davernicct/work_ide/git_shell_cmd_prototype_notes.txt

find . -maxdepth 3 -name .git -type d | rev | cut -c 6- | rev | xargs -I {} git -C {} pull // update every repo
