davernicct/work_ide/prototypes/pcb_prod_architecture/Architecture.docx

Nrfjprog : https://infocenter.nordicsemi.com/pdf/nRF5x_Command_Line_Tools_v1.0.pdf

SAM Driver

Programmer API (nrfprog)

Scenario manager

GUI (python)

nRF52 DK

Arduino

PCIe

Pcb proxy

Pcb frame panel

SAM

SWD Programmer

UUT N

….

UUT 2

UUT 1
