davernicct/work_ide/doc_git.docx

Sky_pcb_models

Tattoo_machine_models

…….

project_N

project_1

project_0

frame

components

mec_ide

…….

project_N

project_1

project_0

applications

firmware

modules

integration

external

components

sft_ide

…….

project_N

project_1

project_0

pcb

components

ele_ide

work_ide
