davernicct/work_ide/prototypes/pcb_prod_architecture/register_map.xlsx

par convention : les registres sont sur 32 bits little endian
 | On test une carte à la fois
adr | data | dir | commentaire | designation
1 | pb_rst_n | RW |  | bouton poussoir reset radio
2 | pb_n+ | RW | test non automatisable pour le moment | bouton poussoir incrément sensibilité
3 | pb_n- | RW | test non automatisable pour le moment | bouton poussoir decrément sensibilité
4 | led_blc_n | RO |  | Afficheur LED status batterie
5 | T_led_blc_n | RO |  | Periode du signal led_blc
6 | led_sync | RO |  | Afficheur LED status connexion radio
7 | T_led_sync | RO |  | Periode du signal led_sync
8 | Alim | RO | mesure sur 8bits (range ADC) | valeur de tension de l'alimentation
9 | nrfcmd | RO |  | control de l'alimentation dermographe
10 | chipselect | RW |  | selection de l'UUT courante
