davernicct/work_ide/prototypes/pcb_prod_architecture/HMI.docx

Set1

Set0

In0

I1

Out0

Out1

Out2

UUT1

Set1

Set0

UUT2

In0

I1

Out0

Out1

Out2

….

Selectionner un scénario

Selectionner une carte cible

Actualiser les scénarios

….

Selection

LANCEMENT

UUTN

SAM X.X Rev X
