davernicct/work_ide/prototypes/pcb_prod_architecture/HMI_RevA.pdf

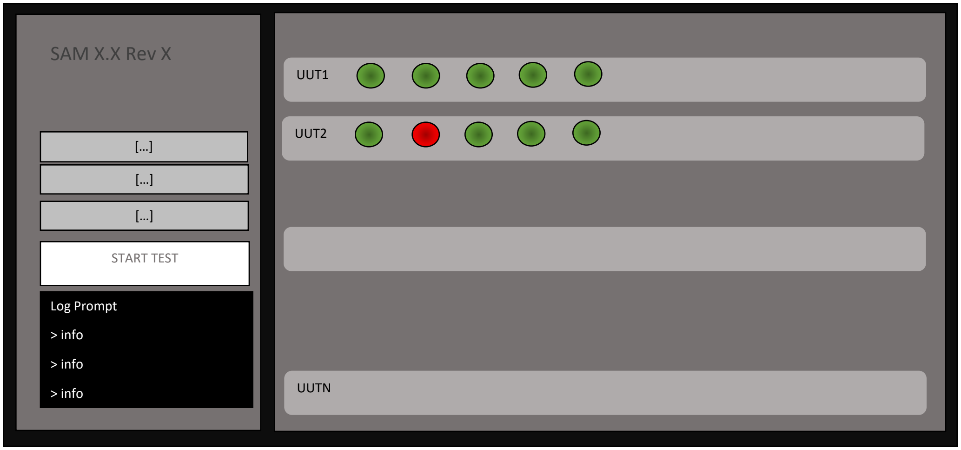
[picture p1: figure]
START TEST; Log Prompt; > info; SAM X.X Rev X; UUT1; UUTN; UUT2
