davernicct/work_ide/prototypes/pcb_prod_architecture/bottom.png

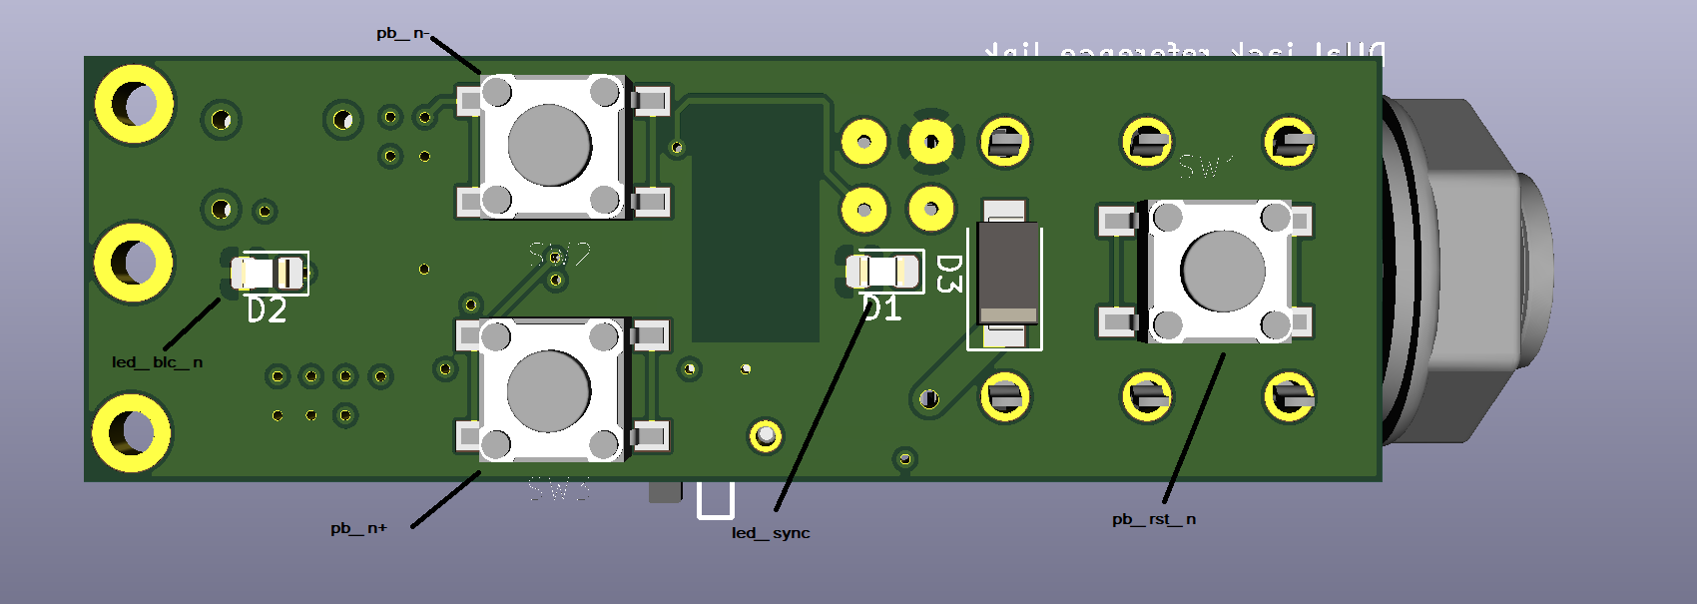
prototypes/pcb_prod_architecture/bottom.png
