davernicct/work_ide/prototypes/pcb_prod_architecture/top.png

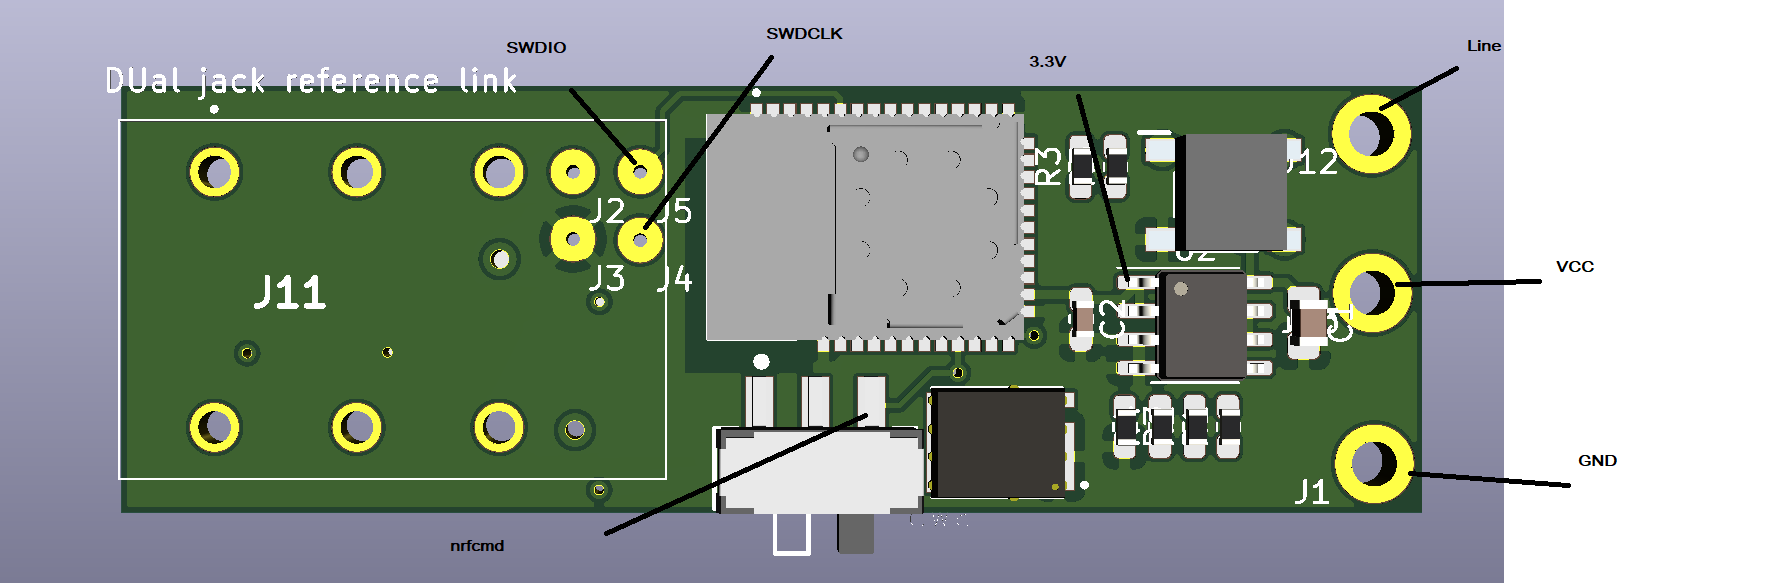
prototypes/pcb_prod_architecture/top.png
