davernicct/work_ide/prototypes/pcb_prod_architecture/Untitled.png

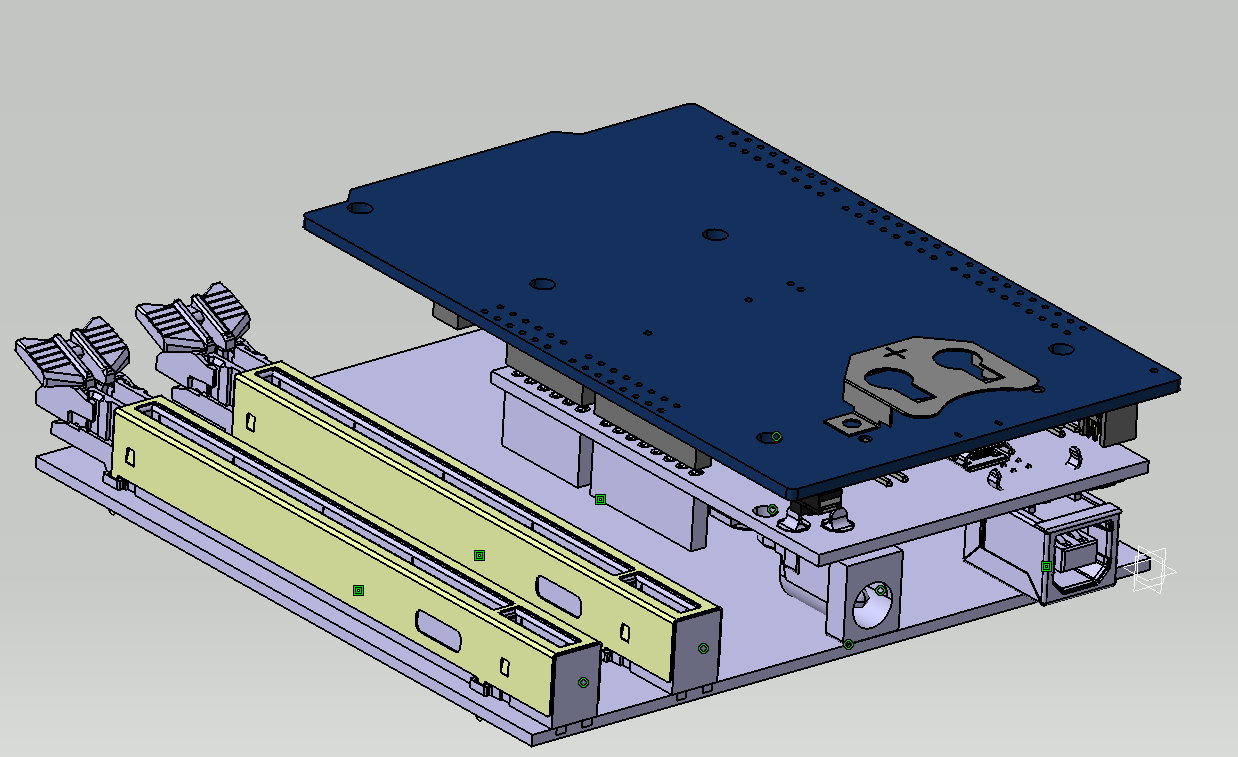
prototypes/pcb_prod_architecture/Untitled.png
