davernicct/work_ide/visual.png

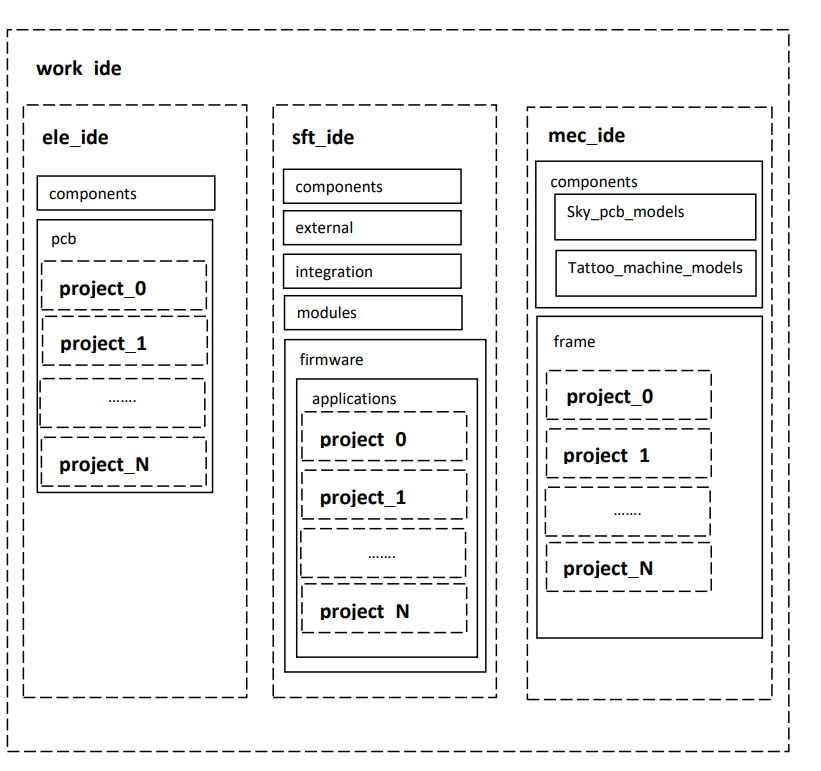
visual.png
