davernicct/work_ide/BOMs/BOM_globale.xlsx

Sheet: Guide de commande
Quantité à produire | 2 | BOM Commande |  |  |  |  |  |  | BOS Commande
Total BOM | 201.49 | Designation | Quantité | Coût/unité article | Quantité pièces/article | Quantité pièces production | Quantité article à commander | Coût cummulé | Service | fournisseur | Capacité et coût
 |  | 10104110-0001LF | 1 | 0.669 | 10 | 2 | 1 | 6.69 | PAR | PCB-WAY | UO | 5 | 20 | 50
 |  | ABS10A13 | 1 | 0.271 | 1 | 2 | 2 | 0.542 |  |  | Prix/UO
 |  | ACJSMHDR | 1 | 1.05 | 1 | 2 | 2 | 2.1
 |  | B3S-1000 | 3 | 0.582 | 1 | 6 | 6 | 3.492
 |  | BL651 farnell | 1 | 6 | 1 | 2 | 2 | 12
 |  | BL652 mouser | 1 | 7 | 1 | 2 | 2 | 14
 |  | BSC016N06NS | 1 | 2.16 | 1 | 2 | 2 | 4.32
 |  | Câble multibrins 0.032mm² | 1 | 0.0007 | 500 | 2 | 1 | 0.35
 |  | Cap 4.7uC 0603 | 2 | 0.135 | 10 | 4 | 1 | 1.35
 |  | Cap 47uC 0603 | 2 | 0.44 | 5 | 4 | 1 | 2.2
 |  | Câble chargeur batterie | 1 | 5.95 | 2 | 2 | 1 | 11.9
 |  | Connecteur fil à carte | 1 | 0.217 | 1 | 2 | 2 | 0.434
 |  | DMC2400UV | 1 | 0.182 | 5 | 2 | 1 | 0.91
 |  | FSR | 1 | 5.05 | 1 | 2 | 2 | 10.1
 |  | Câble multiconducteurs | 1 | 0.152 | 6 | 2 | 1 | 0.912
 |  | Gaine Thr | 1 | 0.176 | 143 | 2 | 1 | 25.168
 |  | Contact PicoBlade | 3 | 0.0263 | 10 | 6 | 1 | 0.263
 |  | JS102011SAQN | 1 | 0.442 | 1 | 2 | 2 | 0.884
 |  | kit boitiers I.Materialise | 1 | 24.99 | 1 | 2 | 2 | 49.98
 |  | LED lens | 2 | 0.115 | 5 | 4 | 1 | 0.575
 |  | Li-Ion | 1 | 15.14 | 1 | 2 | 2 | 30.28
 |  | LP2951-3.3_SOIC | 1 | 0.621 | 1 | 2 | 2 | 1.242
 |  | MCP4461-103E/ML | 1 | 1.69 | 1 | 2 | 2 | 3.38
 |  | MCP73831T-2ACI/OT | 1 | 0.519 | 1 | 2 | 2 | 1.038
 |  | LED_RG | 1 | 0.256 | 5 | 2 | 1 | 1.28
 |  | LED_White | 1 | 0.957 | 1 | 2 | 2 | 1.914
 |  | MCP6541T-I_OT | 1 | 0.334 | 1 | 2 | 2 | 0.668
 |  | PS000122 | 1 | 1.66 | 1 | 2 | 2 | 3.32
 |  | MMSD4148T1G | 2 | 0.125 | 1 | 4 | 4 | 0.5
 |  | Res 10Kr 0603 | 12 | 0.0044 | 10 | 24 | 3 | 0.132
 |  | Res 1.5Mr 0603 | 1 | 0.0265 | 10 | 2 | 1 | 0.265
 |  | pcb JLCPCB | 1 | 1.8 | 5 | 2 | 1 | 9
 |  | Res 180Kr 0603 | 1 | 0.0252 | 10 | 2 | 1 | 0.252
 |  | Res 220r 0603 | 3 | 0.0049 | 10 | 6 | 1 | 0.049

Sheet: BOM Unité
BOM Unité
Designation | Quantité | Coût/unité article | Quantité pièces/article | Coût cummulé | Fournisseur | Lien fournisseur | Catégorie | PCBA | BOM/unité | 78.7798
10104110-0001LF | 1 | 0.669 | 10 | 0.669 | Farnell | https://fr.farnell.com/amphenol-icc-fci/10104110-0001lf/embase-micro-usb-2-0-type-b-cms/dp/2293753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|pcrid|80994017342|plid||kword||match||slid||product|2293753|pgrid|18029979182|ptaid|aud-890751158535:pla-41477300408|&CMP=KNC-GFR-GEN-SHOPPING_TEST_93_08-APR-2020_T | CMP-G-COMMON | Y-SMD | CMP | 45.8638 | R-COMMON | 15.2709
ABS10A13 | 1 | 0.271 | 1 | 0.271 | Farnell | https://fr.farnell.com/diodes-inc/abs10a-13/diode-pont-redresseur-1-ph-1a/dp/3127182?st=ABS10A13 | CMP-R-COMMON | Y-SMD |  |  | G-COMMON | 29.8885
ACJSMHDR | 1 | 1.05 | 1 | 1.05 | Farnell | https://fr.farnell.com/amphenol/acjs-mhdr/jack-6-35mm-pcb-stereo/dp/1835537?st=ACJSMHDR | CMP-R-COMMON | N |  |  | COMMON | 0.7044
B3S-1000 | 3 | 0.582 | 1 | 1.746 | Farnell | https://fr.farnell.com/omron/b3s-1000/commutateur-cms-spno-50ma/dp/177807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 | CMP-R-COMMON | Y-SMD | PCB | 1.8 | R-COMMON | 0
BL651 farnell | 1 | 6 | 1 | 6 | farnell | https://fr.farnell.com/laird/453-00005c/bl651-series-bt-v5-module-int/dp/3020333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 (https://fr.farnell.com/laird-technologies/bl652-sa-01/module-ble-nfc-2-402-2-48ghz-96dbm/dp/2664536?st=BL652) | CMP-G-COMMON | Y-SMD |  |  | G-COMMON | 0
BL652 mouser | 1 | 7 | 1 | 7 | mouser | https://www.mouser.fr/ProductDetail/Laird-Connectivity/BL652-SA-01 (https://fr.farnell.com/laird/453-00005c/bl651-series-bt-v5-module-int/dp/3020333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) | CMP-R-COMMON | Y-SMD |  |  | COMMON | 1.8
BSC016N06NS | 1 | 2.16 | 1 | 2.16 | Farnell | https://fr.farnell.com/infineon/bsc016n06nsatma1/mosfet-canal-n-60v-100a-tdson/dp/2432702?st=BSC016N06NSATMA1 | CMP-R-COMMON | Y-SMD | BTR | 31.116 | R-COMMON | 0
Câble multibrins 0.032mm² | 1 | 0.0007 | 500 | 0.0007 | Farnell | https://fr.farnell.com/concordia-technologies/6009404/cable-equipment-wire-7-0-20mm/dp/3377814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 | CMP-G-COMMON | / |  |  | G-COMMON | 6.126
Câble multiconducteurs | 1 | 0.152 | 6 | 0.152 | Farnell | https://fr.farnell.com/pro-power/2183y-0-50mmblk/cable-flex-2183y-0-50mm-noir-au/dp/1387675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 | CMP-R-COMMON | / |  |  | COMMON | 24.99
Cap 4.7uC 0603 | 2 | 0.135 | 10 | 0.27 | Farnell | https://fr.farnell.com/yageo/cc0603zry5v5bb475/condensateur-4-7-f-6-3v-y5v-0603/dp/9402128 | CMP-COMMON | Y-SMD
Cap 47uC 0603 | 2 | 0.44 | 5 | 0.88 | Farnell | https://fr.farnell.com/murata/grm21br60j476me15l/condensateur-47-f-6-3v-20-x5r/dp/2362109 | CMP-COMMON | Y-SMD
Câble chargeur batterie | 1 | 5.95 | 2 | 5.95 | NetDot | https://www.amazon.fr/gp/product/B07CHCV7M6/ref=ppx_yo_dt_b_asin_title_o01_s00?ie=UTF8&psc=1 | BTR-G-COMMON | /
Connecteur fil à carte | 1 | 0.217 | 1 | 0.217 | Farnell | https://fr.farnell.com/molex/51047-0300/connecteur-male-3-voies-1-rangee/dp/2112415?st=510470300 | CMP-G-COMMON | / | BOS
Contact PicoBlade | 3 | 0.0263 | 10 | 0.0789 | Farnell | https://fr.farnell.com/molex/50125-8000/contact-m-le-26awg-a-sertir/dp/1756745?st=501258000 | CMP-G-COMMON | / | SMD | 21 | 39
DMC2400UV | 1 | 0.182 | 5 | 0.182 | Farnell | https://fr.farnell.com/diodes-inc/dmc2400uv-7/mosfet-canal-n-p-20v-sot-563-6/dp/2543523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 | CMP-G-COMMON | Y-SMD | THUH | 1 | 1
FSR | 1 | 5.05 | 1 | 5.05 | Farnell | https://fr.farnell.com/multicomp/mcwr06x1002ftl/res-couche-epaisse-10k-1-0-1w/dp/2447230 | CMP-G-COMMON | /
Gaine Thr | 1 | 0.176 | 143 | 0.176 | Farnell | https://fr.farnell.com/pro-power/13654/gaine-thermo-2-1-noir-50-8-5m/dp/1008451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 | BTR-G-COMMON | /
JS102011SAQN | 1 | 0.442 | 1 | 0.442 | Farnell | https://fr.farnell.com/c-k-components/js102011saqn/commutateur-spdt-0-6a-6vdc-lateral/dp/2320017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 | CMP-R-COMMON | Y-SMD
kit boitiers I.Materialise | 1 | 24.99 | 1 | 24.99 | I.Materialise |  | BTR-COMMON | /
LED lens | 2 | 0.115 | 5 | 0.23 | Farnell | https://fr.farnell.com/vcc-visual-communications-company/cmc321ctp/lentille-led-5mm-pc-transparent/dp/2750614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 | CMP-R-COMMON | /
LED_RG | 1 | 0.256 | 5 | 0.256 | Farnell | https://fr.farnell.com/kingbright/kptb-1612surkcgkc/led-cms-80-50mcd-rouge-vert/dp/2426234?st=KPTB1612SURKCGKC | CMP-R-COMMON | Y-SMD
LED_White | 1 | 0.957 | 1 | 0.957 | Farnell | https://fr.farnell.com/broadcom-limited/hsmw-c191/led-cms-blanc/dp/1058375 | CMP-R-COMMON | Y-SMD
Li-Ion | 1 | 15.14 | 1 | 15.14 | Farnell | https://fr.farnell.com/bak/lp-402025-is-3/batterie-lithium-pol-3-7v-165/dp/2077885 | CMP-G-COMMON | /
LP2951-3.3_SOIC | 1 | 0.621 | 1 | 0.621 | Farnell | https://fr.farnell.com/texas-instruments/lp2951-33d/ic-volt-reg-3-3v-mcrpwr-sd-8soic/dp/3122132?st=LP2951-33D | CMP-R-COMMON | Y-ThuHole
MCP4461-103E/ML | 1 | 1.69 | 1 | 1.69 | Farnell | https://fr.farnell.com/microchip/mcp4461-103e-ml/ic-dgtl-pot-257taps-10k-20qfn/dp/1863948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 | CMP-G-COMMON | Y-SMD
MCP6541T-I_OT | 1 | 0.334 | 1 | 0.334 | Farnell | https://fr.farnell.com/microchip/mcp6541t-i-ot/comp-pushpull-1-6v-sngl-5sot23/dp/1825063?st=MCP6541T-I_OT | CMP-G-COMMON | Y-SMD
MCP73831T-2ACI/OT | 1 | 0.519 | 1 | 0.519 | Farnell | https://fr.farnell.com/microchip/mcp73831t-2aci-ot/controleur-de-charge-li-ion-li/dp/1332158?st=MCP73831 | CMP-G-COMMON | Y-SMD
MMSD4148T1G | 2 | 0.125 | 1 | 0.25 | Farnell | https://fr.farnell.com/on-semiconductor/mmsd4148t1g/diode-rapide-sod-123/dp/9556079?st=MMSD4148T1G | CMP-COMMON | Y-SMD
pcb JLCPCB | 1 | 1.8 | 5 | 1.8 | JLCPCB | / | PCB-COMMON | /
PS000122 | 1 | 1.66 | 1 | 1.66 | Farnell | https://fr.farnell.com/pro-signal/ps000122/phone-audio-conn-plug-3pos-6-35mm/dp/2910967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 | CMP-R-COMMON | /
Res 1.5Mr 0603 | 1 | 0.0265 | 10 | 0.0265 | Farnell | https://fr.farnell.com/yageo/rc0603fr-071m5l/res-couche-epaisse-1m5-1-0-1w/dp/9238867 | CMP-G-COMMON | Y-SMD
Res 10Kr 0603 | 12 | 0.0044 | 10 | 0.0528 | Farnell | https://fr.farnell.com/multicomp/mcwr06x1002ftl/res-couche-epaisse-10k-1-0-1w/dp/2447230 | CMP-COMMON | Y-SMD
Res 180Kr 0603 | 1 | 0.0252 | 10 | 0.0252 | Farnell | https://fr.farnell.com/yageo/rc0603fr-07180kl/res-couche-epaisse-180k-1-0-1w/dp/9238751 | CMP-G-COMMON | Y-SMD
Res 1Mr 0603 | 1 | 0.0088 | 10 | 0.0088 | Farnell | https://fr.farnell.com/multicomp/mcmr06x1004ftl/res-ceramique-1m-1-0-1w-0603/dp/2073351 | CMP-G-COMMON | Y-SMD
Res 220r 0603 | 3 | 0.0049 | 10 | 0.0147 | Farnell | https://fr.farnell.com/multicomp/mcwr06x2200ftl/res-couche-epaisse-220r-1-0-1w/dp/2447298 | CMP-R-COMMON | Y-SMD

Sheet: BOM Multiref
Liste fournisseurs | PCBA status | Multiref boitiers |  |  |  |  | Multiref pcb
Farnell | / | reference article | Coût/unité article | Quantité pièces/article | Fournisseur | Lien fournisseur | reference article | Coût/unité article | Quantité pièces/article | Fournisseur | Lien fournisseur
Sculpteo | N | kit boitiers Sculpteo | 51.07 | 1 | Sculpteo | / | pcb JLCPCB | 1.8 | 5 | JLCPCB | /
JLCPCB | Y-SMD | kit boitiers I.Materialise | 24.99 | 1 | I.Materialise | /
Mouser | Y-ThuHole | / | 30 | 1 | type2
 |  | / | 30 | 1 | type3 | /
 |  | Multiref BL651
 |  | reference article | Coût/unité article | Quantité pièces/article | Fournisseur | Lien fournisseur
 |  | BL651 farnell | 6 | 1 | farnell | https://fr.farnell.com/laird/453-00005c/bl651-series-bt-v5-module-int/dp/3020333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
 |  | BL651 mouser | 4.76 | 1 | mouser | https://www.mouser.fr/ProductDetail/Laird-Connectivity/453-00006
 |  | Multiref BL652
 |  | reference article | Coût/unité article | Quantité pièces/article | Fournisseur | Lien fournisseur
 |  | BL652 farnell | 8.39 | 1 | farnell | https://fr.farnell.com/laird-technologies/bl652-sa-01/module-ble-nfc-2-402-2-48ghz-96dbm/dp/2664536?st=BL652
 |  | BL652 mouser | 7 | 1 | mouser | https://www.mouser.fr/ProductDetail/Laird-Connectivity/BL652-SA-01
