davernicct/work_ide/BOMs/ele_BOM_SKY_misc.xlsx

Quantity | Designation | Commentaire | Fournisseur | lien | Pu
1 | Commutateur alim demo | Demo only | farnell | https://fr.farnell.com/nidec-copal/mfs201n-z/commut-glissiere-dpdt-1a-120v/dp/2854848 | 1.03
2 | CR2032 | Demo only | farnell | https://fr.farnell.com/renata/cr-2032-mfr-rv/pile-bouton-3-broches-3v/dp/1823483?st=CR2032 | 1.02
1 | NYS224 | External supply only, cette référence peut -être moins chère | farnell | https://fr.farnell.com/rean/nys224bg/fiche-male-6-35mm-2-voies-noire/dp/1813728?st=NYS224 | 3.38
 |  |  |  | Total | 5.43
