davernicct/work_ide/BOMs/ele_BOM_SKY_R.xlsx

 |  |  |  |  |  | Mouser |  |  | Farnell
Id | Designator | Package | Quantity | Designation | Commentaire | lien | Pu | Total | lien | Pu | Total
1 | Q1 | BSC016N06NS | 1 | Q_NMOS_GSD | / | https://www.mouser.fr/ProductDetail/Infineon-Technologies/BSC016N06NS | 1.85 | 1.85 | https://fr.farnell.com/infineon/bsc016n06nsatma1/mosfet-canal-n-60v-100a-tdson/dp/2432702?st=BSC016N06NSATMA1 | 2.16 | 2.16
2 | J11 | ACJSMHDR | 1 | AudioJack3_Dual_Switch | / | https://www.mouser.fr/ProductDetail/Amphenol-Audio/ACJS-MHDR | 1.28 | 1.28 | https://fr.farnell.com/amphenol/acjs-mhdr/jack-6-35mm-pcb-stereo/dp/1835537?st=ACJSMHDR | 1.05 | 1.05
3 | J5,J4,J3,J2 | ProbePad | 4 | Conn_01x01 | NC | / | 0 | 0 | / | 0 | 0
4 | J13,J12,J1 | PowerPad | 3 | Conn_01x01 | NC | / | 0 | 0 | / | 0 | 0
5 | IC1 | 45300005 | 1 | 453-00005 | stock volatile | https://www.mouser.fr/ProductDetail/Laird-Connectivity/BL652-SA-01-T-R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 | 6.71 | 6.71 | https://fr.farnell.com/laird-technologies/bl652-sa-01/module-ble-nfc-2-402-2-48ghz-96dbm/dp/2664536?st=BL652 | 8.23 | 8.23
6 | R7,R3,R2,R1 | R_0603_1608Metric_Pad1.05x0.95mm_HandSolder | 4 | 10kR | prix générique | / | 0.45 | 1.8 | / | 0.45 | 1.8
7 | R5,R4 | R_0603_1608Metric_Pad1.05x0.95mm_HandSolder | 2 | 220R | prix générique | / | 0.45 | 0.9 | / | 0.45 | 0.9
8 | C1 | C_0805_2012Metric_Pad1.15x1.40mm_HandSolder | 1 | 4.7uC | prix générique | / | 0.45 | 0.45 | / | 0.45 | 0.45
9 | SW2,SW3,SW1 | SW_B3S-1000 | 3 | B3S-1000 | / | https://www.mouser.fr/ProductDetail/Omron-Electronics/B3S-1000 | 0.531 | 1.593 | https://fr.farnell.com/omron/b3s-1000/commutateur-cms-spno-50ma/dp/177807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 | 0.582 | 1.746
10 | D4 | ABS10A13 | 1 | ABS10A-13 | / | https://www.mouser.fr/ProductDetail/Diodes-Incorporated/ABS10A-13 | 0.351 | 0.351 | https://fr.farnell.com/diodes-inc/abs10a-13/diode-pont-redresseur-1-ph-1a/dp/3127182?st=ABS10A13 | 0.271 | 0.271
11 | S1 | JS102011SAQN | 1 | Bypass | / | https://www.mouser.fr/ProductDetail/CK/JS102011SAQN | 0.45 | 0.45 | https://fr.farnell.com/c-k-components/js102011saqn/commutateur-spdt-0-6a-6vdc-lateral/dp/2320017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 | 0.442 | 0.442
12 | D3 | D_SMA | 1 | MMSD4148T1G | / | https://www.mouser.fr/ProductDetail/863-MMSD4148T1G | 0.108 | 0.108 | https://fr.farnell.com/on-semiconductor/mmsd4148t1g/diode-rapide-sod-123/dp/9556079?st=MMSD4148T1G | 0.125 | 0.125
13 | U2 | SOIC-8_3.9x4.9mm_P1.27mm | 1 | LP2951-3.3_SOIC | / | https://www.mouser.fr/ProductDetail/Texas-Instruments/LP2951D | 0.621 | 0.621 | https://fr.farnell.com/texas-instruments/lp2951-33d/ic-volt-reg-3-3v-mcrpwr-sd-8soic/dp/3122132?st=LP2951-33D | 0.571 | 0.571
14 | D2 | LED_0805_2012Metric_Pad1.15x1.40mm_HandSolder | 1 | led_blc | / | https://www.mouser.fr/ProductDetail/Broadcom-Avago/HSMS-C170 | 0.342 | 0.342 | https://fr.farnell.com/broadcom-limited/hsmh-c150/led-cms-rouge/dp/8554633 | 0.307 | 0.307
15 | D1 | LED_0805_2012Metric_Pad1.15x1.40mm_HandSolder | 1 | led_sync | Priorité réf Mouser | https://www.mouser.fr/ProductDetail/859-LTW-170TK | 0.41 | 0.41 | https://fr.farnell.com/broadcom-limited/hsmw-c191/led-cms-blanc/dp/1058375 | 0.361 | 0.361
16 | C2 | C_0603_1608Metric_Pad1.05x0.95mm_HandSolder | 1 | 100C | prix générique | / | 0.45 | 0.45 | / | 0.45 | 0.45
17 | / | Jack 6.35mm stéréo connector | 1 | PS000122 | / | / | / | / | https://fr.farnell.com/pro-signal/ps000122/phone-audio-conn-plug-3pos-6-35mm/dp/2910967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 | 1.66 | 1.66
18 | / | Lentille led | 2 | CMC321CTP | par paquet de 5 | / | / | / | https://fr.farnell.com/vcc-visual-communications-company/cmc321ctp/lentille-led-5mm-pc-transparent/dp/2750614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 | 0.115 | 0.23
 |  |  |  |  | BOM composants | 19.205 |  | € | 20.753 |  | €
 |  |  |  |  | BOM pcb | 5.8 |  | € | 5.8 |  | €
 |  |  |  |  | Total fab electronics | 25.005 |  | € | 26.553 |  | €
