davernicct/work_ide/BOMs/mec_BOM.xlsx

Designation | Commentaire | méthode de production | matériaux | Fournisseur | Pu
Relay case bottom |  | I3D multijet | Nylon PA12 (gris) | Sculpteo | 14.42
Relay case top |  | I3D multijet | Nylon PA12 (gris) | Sculpteo | 9.38
Relay case cap |  | I3D multijet | Nylon PA12 (gris) | Sculpteo | 8.06
Relay sens button |  | I3D multijet | Nylon PA12 (noir) | Sculpteo | 6.6
Relay main button |  | I3D multijet | Nylon PA12 (noir) | Sculpteo | 6.6
Relay slide button |  | I3D multijet | Nylon PA12 (noir) | Sculpteo | 6.6
Grip frame |  | I3D multijet | Nylon PA12 (noir) | Sculpteo | 21.69
Grip frame cap |  | I3D multijet | Nylon PA12 (noir) | Sculpteo | 9.24
 |  |  |  | Total | 82.59
