davernicct/work_ide/BOMs/ele_BOM_SKY_G.xlsx

 |  |  |  |  |  | Mouser |  |  | Farnell
Id | Designator | Package | Quantity | Designation | Commentaire | lien | Pu | Total | lien | Pu | Total
1 | J1 | PinHeader_1x03_P1.27mm_Horizontal | 1 | Conn_01x03 | NC | / | 0 | 0 | / | 0 | 0
2 | IC3 | SOT95P270X145-5N | 1 | MCP6541T-I_OT |  | https://www.mouser.fr/ProductDetail/Microchip-Technology/MCP6541T-I-OT | 0.324 | 0.324 | https://fr.farnell.com/microchip/mcp6541t-i-ot/comp-pushpull-1-6v-sngl-5sot23/dp/1825063?st=MCP6541T-I_OT | 0.334 | 0.334
3 | S1 | SOT65P210X110-6N | 1 | TS5A3157DCKR |  | https://www.mouser.fr/ProductDetail/Texas-Instruments/TS5A3157DCKR | 0.369 | 0.369 | https://fr.farnell.com/texas-instruments/ts5a3157dckr/analogue-switch-1-ch-sc-70-6/dp/3005462?st=TS5A3157DCKR | 0.331 | 0.331
4 | IC2 | SOP65P640X120-20N | 1 | MCP4461-103E_ST |  | https://www.mouser.fr/ProductDetail/Microchip-Technology/MCP4461-103E-ST | 1.69 | 1.69 | https://fr.farnell.com/microchip/mcp4461-103e-st/dgtl-pot-257taps-10k-20tssop/dp/1863949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 | 1.74 | 1.74
5 | IC1 | 45300005 | 1 | 453-00005 | stock volatile | https://www.mouser.fr/ProductDetail/Laird-Connectivity/453-00005 | 4.64 | 4.64 | https://fr.farnell.com/laird/453-00005c/bl651-series-bt-v5-module-int/dp/3020333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 | 5.88 | 5.88
6 | J7,J9,J11 | ProbePad | 3 | VTP_GND | NC | / | 0 | 0 | / | 0 | 0
7 | J2 | PinHeader_1x02_P1.27mm_Vertical | 1 | Sensor_IO | NC | / | 0 | 0 | / | 0 | 0
8 | C1 | C_0603_1608Metric_Pad1.05x0.95mm_HandSolder | 1 | C | prix générique |  | 0.45 | 0.45 |  | 0.45 | 0.45
9 | J3 | ProbePad | 1 | SWDIO | NC | / | 0 | 0 | / | 0 | 0
10 | J4 | ProbePad | 1 | SWDCLK | NC | / | 0 | 0 | / | 0 | 0
11 | J5 | ProbePad | 1 | nReset | NC | / | 0 | 0 | / | 0 | 0
12 | J6,J8,J10 | ProbePad | 3 | VTP_Vcc | NC | / | 0 | 0 | / | 0 | 0
13 | R1,R3,R4,R5,R6,R7,R8 | R_0603_1608Metric_Pad1.05x0.95mm_HandSolder | 7 | R | prix générique |  | 0.45 | 3.15 |  | 0.45 | 3.15
14 | R2 | R_0603_1608Metric_Pad1.05x0.95mm_HandSolder | 1 | 10kR | prix générique |  | 0.45 | 0.45 |  | 0.45 | 0.45
 |  |  |  |  | BOM composants | 11.073 |  | € | 12.335 |  | €
 |  |  |  |  | BOM pcb | 2.6 |  | € | 2.6 |  | €
 |  |  |  |  | Total fab electronics | 13.673 |  | € | 14.935 |  | €
