davernicct/work_ide/BOMs/production/BOM_Sky_kit.xlsx

Item # | Designator | Quantity | Manufacturer | Manufacturer part nb | Description / Value | Package | Type | Comment | Type list
1 | C2, C4 | 2 | YAGEO | CC0603ZRY5V5BB475 | 4.7uC | 603 | SMD |  | SMD
2 | C1, C3 | 2 | MURATA | GRM21BR60J476ME15L | 47uC | 603 | SMD |  | DNS
3 | D1, | 1 | KINGBRIGHT | KPTB-1612SURKCGKC | KPTB-1612SURKCGKC | KPTB-1612SURKCGKC | SMD | Relatively close to 0603 package
4 | D2, | 1 | BROADCOM | HSMW-C191 | HSMW-C191 | HSMW-C191 | SMD | Relatively close to 0603 package
5 | D3, | 1 | DIODE INC. | ABS10A-13 | ABS10A-13 | SOPA-4 | SMD
6 | D4, D5 | 2 | ON SEMICONDUCTOR | MMSD4148T1G | MMSD4148T1G | SOD-123 | SMD
7 | IC1, | 1 | LAIRD | BL652-SA-01 | BL652 | 14 x 10mm | SMD | Non standard Package (LAIRD System on Module)
12 | Q1, | 1 | INFINEON | BSC016N06NSATMA1 | BSC016N06NS | PG-TDSON-8 FL | SMD
13 | R1, R2, R3, | 3 | MULTICOMP PRO | MCWR06X2200FTL | 220R | 603 | SMD
10 | R8 | 1 | MULTICOMP PRO | MCWR06X1002FTL | 10kR | 603 | SMD
14 | R4, R5, R6, R7 | 4 | MULTICOMP PRO | MCWR06X1002FTL | 10kR | 603 | DNS
15 | SW1, SW2, SW3, | 3 | OMRON | B3S-1000 | B3S-1000 | 6.6 x 6mm | SMD | PushButtons, appears in pick and place but non flat surface on the top
16 | SW4, | 1 | C & K COMPONENTS | JS102011SAQN | JS102011SAQN | 9 x 3.5mm | SMD | Slide Button, appears in pick and place file may have to be considered as ThroughHole component
17 | U1, | 1 | TEXAS INSTRUMENTS | LP2951-33D | LP2951-3.3_SOIC | SOIC-8 | SMD
18 | IC2, | 1 | LAIRD | 453-00005C | BL651 | 14 x 10mm | SMD | Non standard Package (LAIRD System on Module)
19 | R9, | 1 | YAGEO | RC0603FR-071M5L | 1M5R | 603 | SMD
20 | R10, | 1 | MULTICOMP PRO | MCSR06X1803FTL | 180kR | 603 | SMD
21 | R11, | 1 | MULTICOMP PRO | MCMR06X1004FTL | 1MR | 603 | SMD
23 | U2, | 1 | MICROCHIP | MCP73831T-2ACI/OT | MCP73831-2-OT | SOT-23 | SMD
24 | U3, | 1 | MICROCHIP | MCP4461-103E/ML | MCP4461-103E/ML | QFN-20 | SMD
25 | U4, | 1 | MICROCHIP | MCP6541T-I/OT | MCP6541T-I_OT | SOT-23 | SMD
26 | U5, | 1 | DIODE INC. | DMC2400UV-7 | DMC2400UV | SOT-563 | SMD
 | Number of parts | 28
 | Number of SMD parts | 28
 | Number of unique parts | 21
