davernicct/work_ide/BOMs/production/Capture_centroid_Sky_kit.PNG

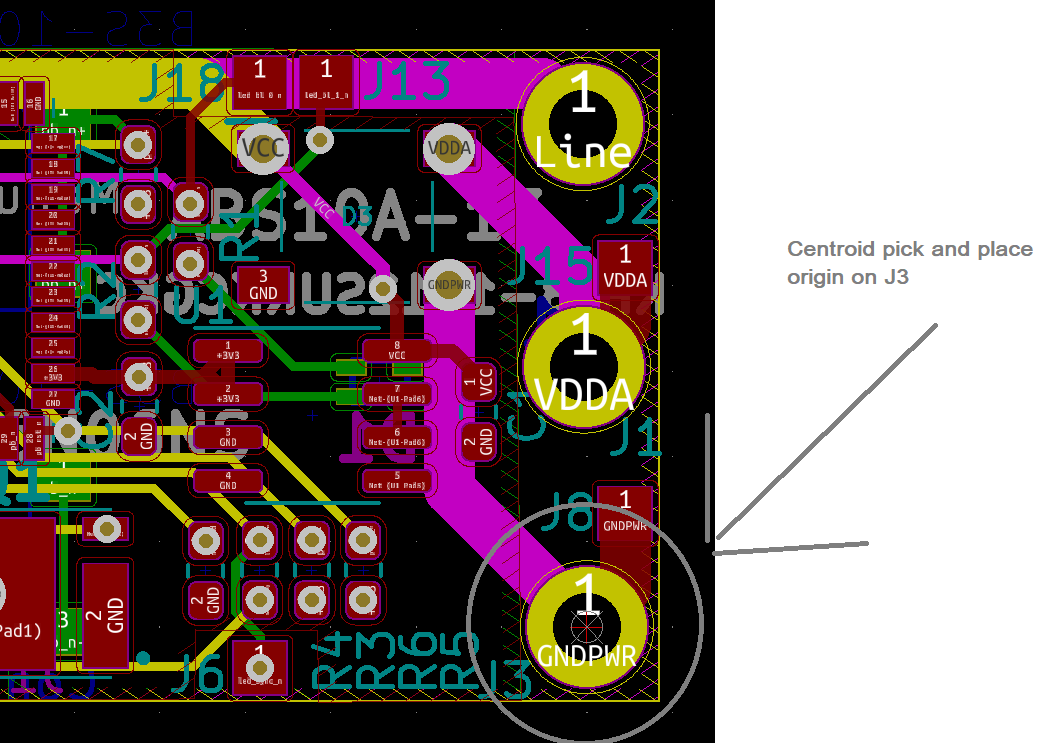
BOMs/production/Capture_centroid_Sky_kit.PNG
