davernicct/work_ide/BOMs/production/sky_solnova_frame.stl

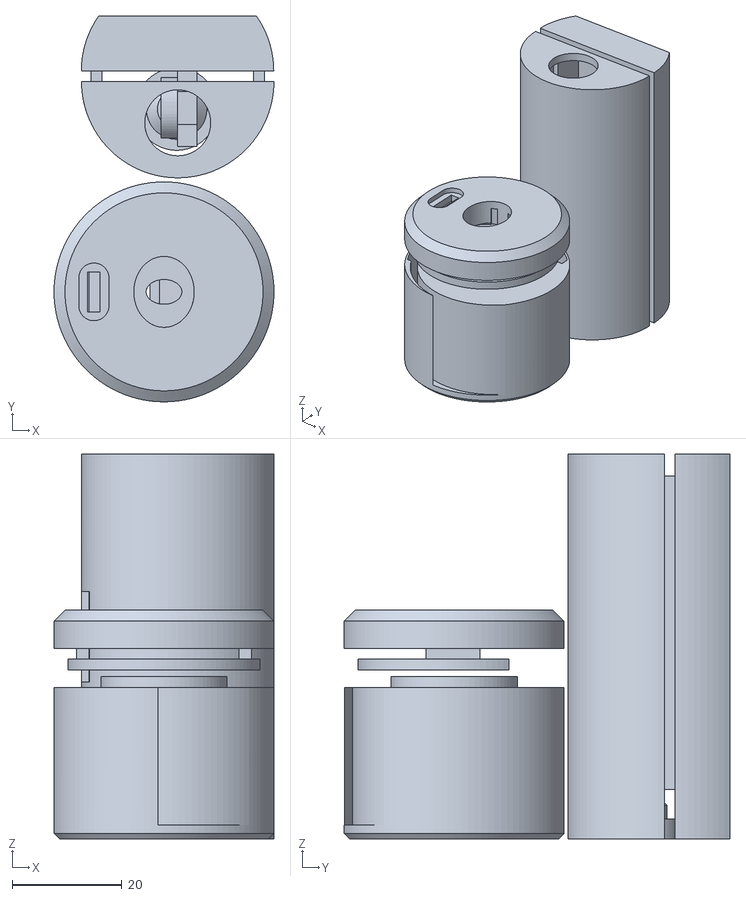
[picture p12: CAD file, 2020-04-24]
BOMs/production/sky_solnova_frame.stl
40.0 x 70.1 x 70.0
