davernicct/work_ide/(list of files, cad)

Other CAD files:
prototypes/packaging/Mousse.CATPart
prototypes/packaging/boitie.CATPart
