davernicct/work_ide/prototypes/pcb_prod_architecture/Architecture.pdf

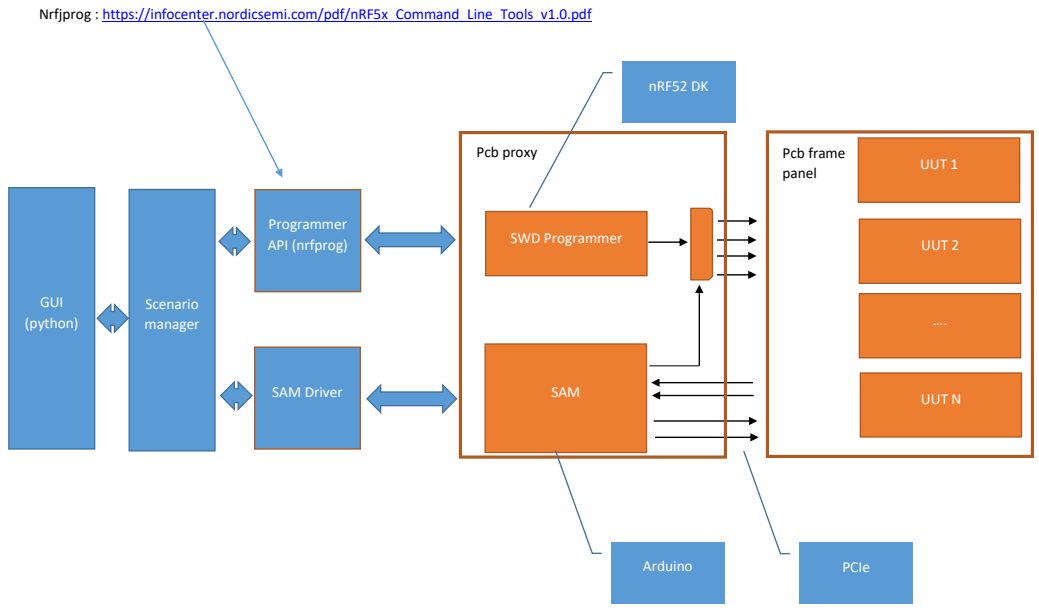
[picture p13: page 1]
SWD Programmer; SAM; Programmer API (nrfprog); UUT 1; UUT 2; UUT N; Pcb frame panel; Pcb proxy; PCIe; GUI (python); Arduino; nRF52 DK; SAM Driver; Scenario manager

Nrfjprog : https://infocenter.nordicsemi.com/pdf/nRF5x_Command_Line_Tools_v1.0.pdf
