davernicct/work_ide/prototypes/pcb_prod_architecture/HMI_RevB.pdf

## SAM X.X Rev X

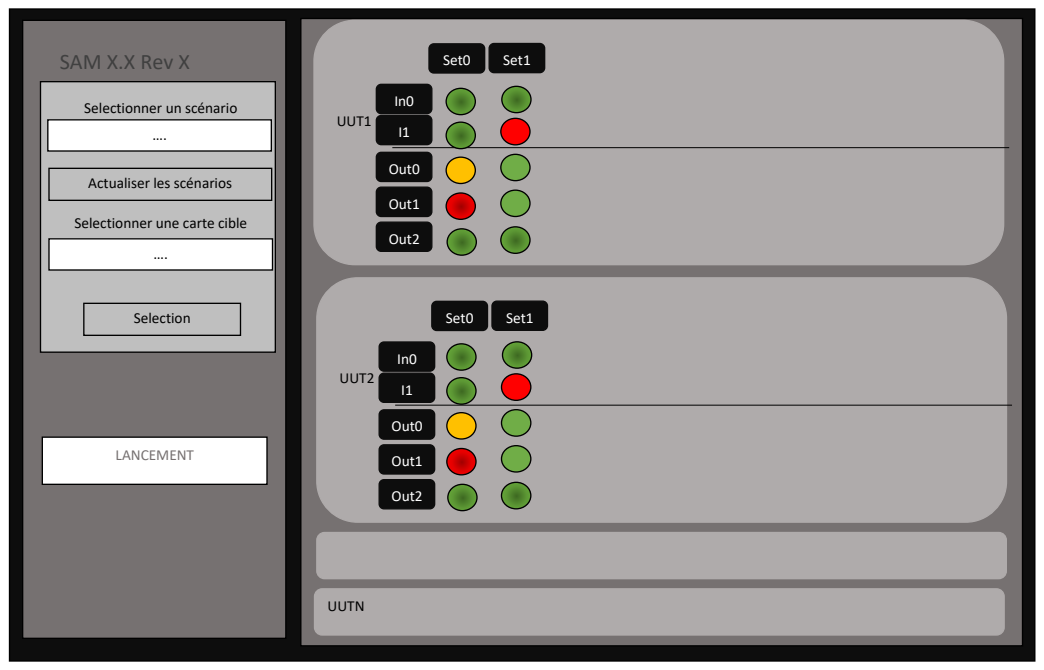
[picture p14: page 1]
Selection; LANCEMENT; UUTN; UUT2; Out0; Out1; Out2; Set0; Set1; UUT1

Selectionner un scénario

Actualiser les scénarios

Selectionner une carte cible
