davernicct/work_ide/log de suivi des tests demo.txt

Cahier de suivi des tests du dispositif de demonstration sky
t0 : 
Mercredi 1er Avril début des tests avec deux piles alcalines cr2032 de 250mAh chacune (piles achetées dans le commerce (Foxter))

t2 : 
le module periphérique une fois sorti de son mode veille ne cesse d'émettre sa présence jusqu'à ce qu'il s'appaire avec un central
il faut ajouter un compteur d'état de mise en veille, lors du reveille du périphérique le compteur compte jusqu'à N, si au bout des N secondes ce dernier n'est pas appairé,
il repart en veille

t3 : 
problème de reconnexion du peripherique au module central

t4 : 
problème d'alimentation identifié au niveau des contacts des piles alcalines, à voir s'il s'agit d'un souci de contact ou de capacité des piles
mesure à 2.84V et 2.63V (3.3V initialement)
Faire une connexion solide hors grip frame pour éliminer le potentiel souci de contact et tester la capacité.
12h20 relance du test
