davernicct/work_ide/prototypes/BLENDER_test.png

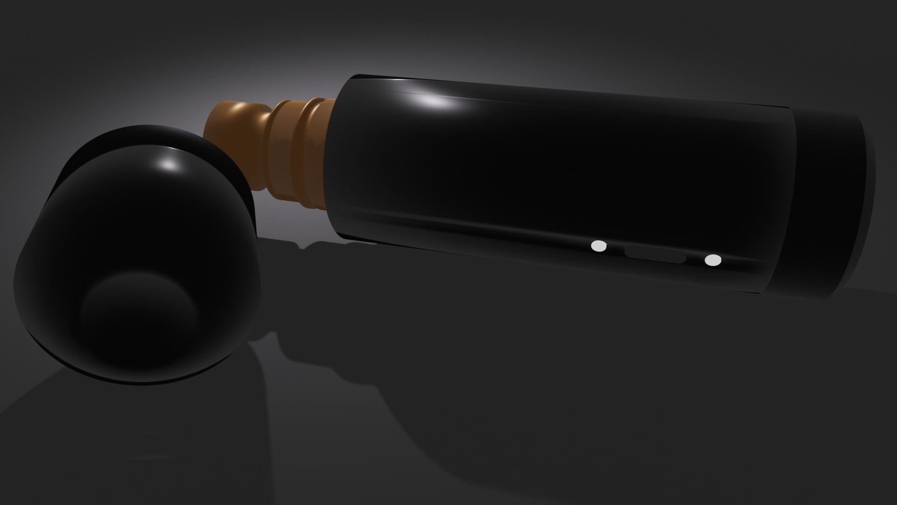
prototypes/BLENDER_test.png
