davernicct/work_ide/(commit log)

2020-03-31 add prototypes folder
2020-04-06 add electronics bom for sky_r sky_g
    [ele_BOM_SKY_G.xlsx, ele_BOM_SKY_R.xlsx]
2020-04-06 ajout des BOMs
    [BOM_globale.xlsx, ele_BOM_SKY_R.xlsx, ele_BOM_SKY_misc.xlsx, mec_BOM.xlsx, register_map.xlsx]
2020-04-09 modification on BOMs
    [BOM_globale.xlsx]
2020-04-09 add prod assembly
    [BOM_globale.xlsx, all_parts.CATProduct, all_parts_revA.stl, all_parts_revB.stl]
2020-04-09 modified BOM and added prod test panels
    [BOM_globale.xlsx, all_parts_revC.stl, grip_only.stl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]
2020-04-10 modified BOMs
    [BOM_globale.xlsx, Relay hammond enclosure.CATPart, Relay.CATProduct, all_parts_sky.CATProduct]
2020-04-23 ajout des fichiers de production
    [BOM_globale.xlsx, Clipper.CATPart, Junction.CATPart, Probe.stl, Relay hammond enclosure.CATPart, Relay.CATProduct, Sonde.CATProduct, all_parts_revA.stl]
2020-04-24 revision des boms
    [BOM_globale.xlsx, BOM_globale_v2.xlsx, sky_solnova.stl]
2020-05-16 update work_ide
    [BOM_Sky_kit.xlsx, BOM_globale.xlsx, BOM_globale_v2.xlsx, Clipper.CATPart, Junction.CATPart, Mousse.CATPart, PNP_Sky_kit.xlsx, Probe.stl]
